tranduclong24102005-dot/NTC-Temperature-Monitoring-Arduino-LM358/CONTENT_NOTICE.md

# Content & copyright notice

The [MIT License](LICENSE) applies to the newly authored Arduino firmware, Python
scripts and original explanatory documentation in this repository to the extent
the publishing author(s) have the legal right to license them.

**The original course report (`report/Cam-bien-original.pdf`) is archival
material, not offered under MIT by this repository.** Images, hardware photos,
manufacturer visuals, logos, and any third-party content retain the rights of
their respective owners. The project owner must check rights and obtain any
necessary permission before public distribution. The extracted prototype image
in `media/` is sourced from the original report and likewise is not
independently licensed under MIT without confirmation of rights.

If sharing the PDF publicly is not permitted, remove it from the repository,
remove or replace links to it, and publish only original, properly licensed
material. For group coursework, credit collaborators with their consent.
