tranduclong24102005-dot/NTC-Temperature-Monitoring-Arduino-LM358/data/calibration_points_from_report.csv

temp_c | resistance_ohm
8 | 21916
29 | 8395
52 | 3345
