tranduclong24102005-dot/NTC-Temperature-Monitoring-Arduino-LM358/(commit log)

2026-11-12 Initial release: NTC temperature monitoring with Arduino and LM358
    [BOM.csv, calibration_points_from_report.csv, comparison_from_report.csv, measurement_template.csv]
2026-11-12 docs: add original circuit schematics from report
2026-11-12 docs: add circuit schematics to English README
